CHESS-mission/PULSE_ENG_PCB/PULSE_3D_Models/C3216X8R1E475M160AE.stp

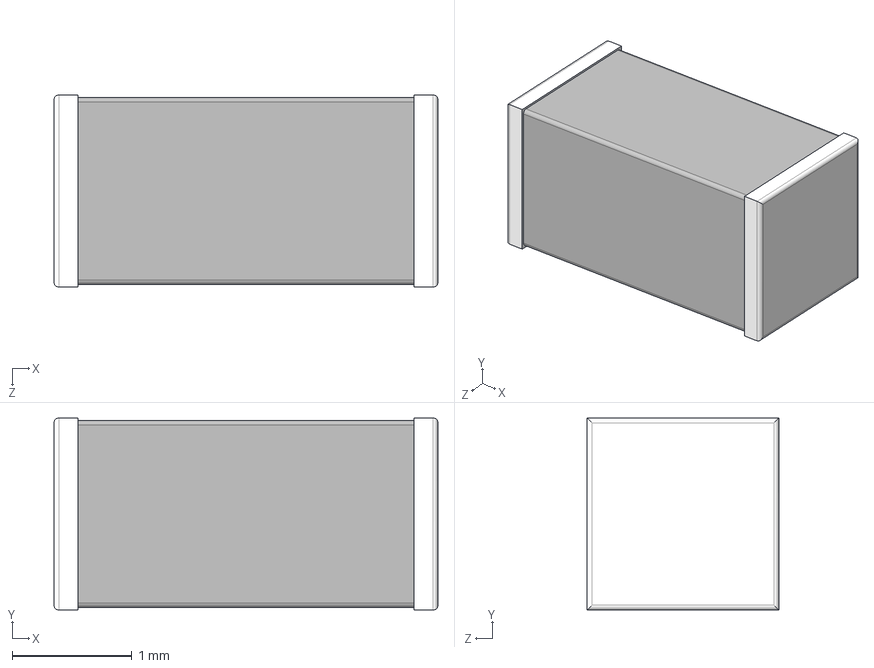
[picture p1: CAD file, 2026-02-26]
PULSE_3D_Models/C3216X8R1E475M160AE.stp
3.20 x 1.60 x 1.60 mm
