CHESS-mission/PULSE_ENG_PCB/PULSE_3D_Models/LM139DR.stp

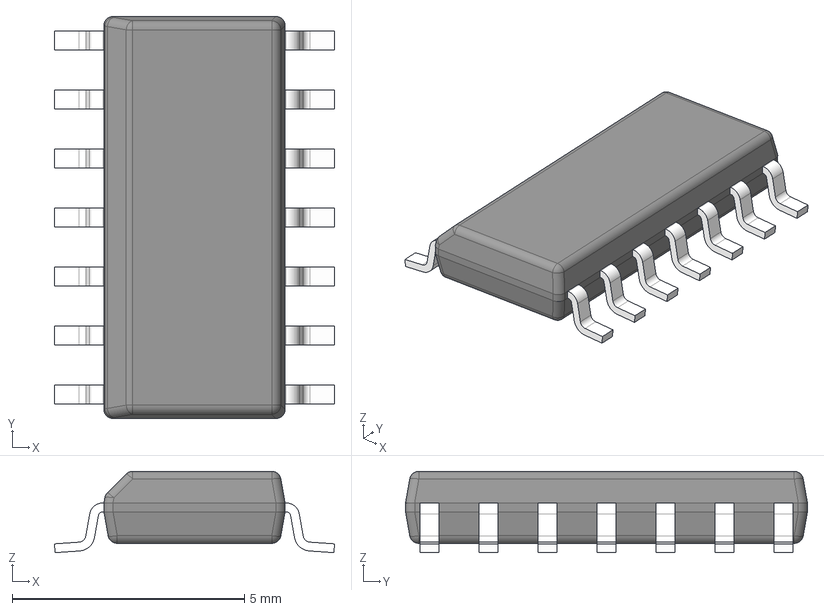
[picture p2: CAD file, 2026-02-26]
PULSE_3D_Models/LM139DR.stp
6.03 x 8.65 x 1.75 mm
BODY-SO
LEAD-SO x 14
PIN1-ID
