CHESS-mission/PULSE_ENG_PCB/PULSE_3D_Models/TPS7B8750QDDARQ1.stp

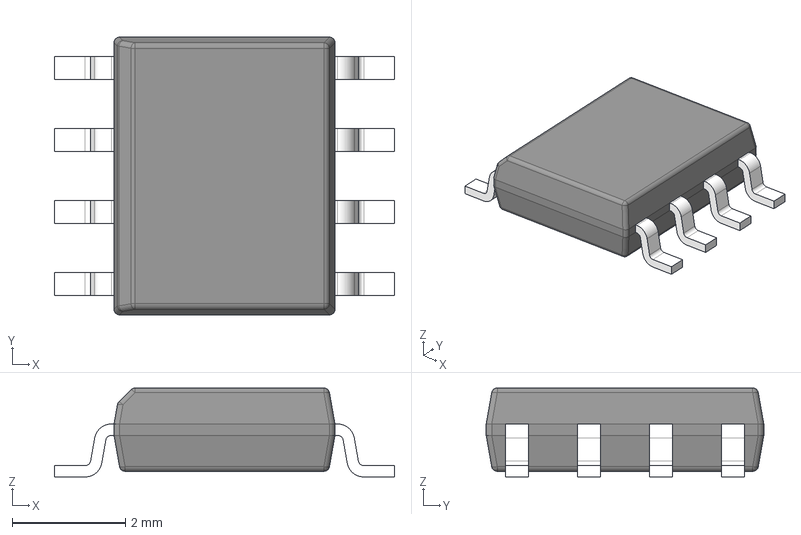
[picture p3: CAD file, 2026-02-26]
PULSE_3D_Models/TPS7B8750QDDARQ1.stp
6.00 x 4.90 x 1.57 mm
BODY-SO
LEAD-SO x 8
THERMALPAD-SO
