CHESS-mission/PULSE_ENG_PCB/PULSE_3D_Models/LT6108AIMS8-1#PBF.stp

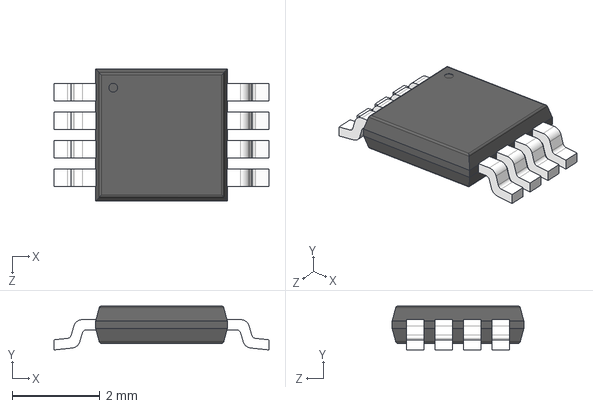
[picture p4: CAD file, 2026-02-26]
PULSE_3D_Models/LT6108AIMS8-1#PBF.stp
4.90 x 1.00 x 3.00 mm
