CHESS-mission/PULSE_ENG_PCB/PULSE_3D_Models/VJ1206Y104KXXAC.stp

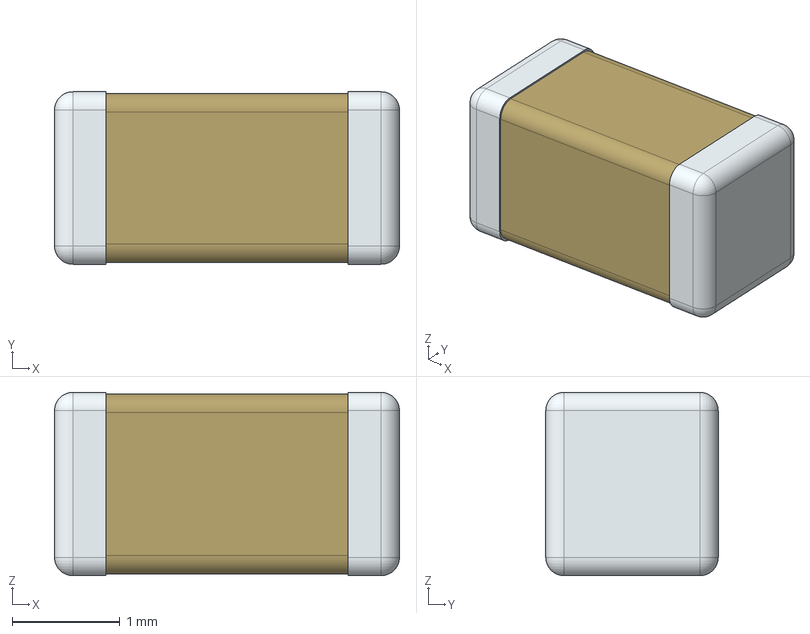
[picture p5: CAD file, 2026-02-26]
PULSE_3D_Models/VJ1206Y104KXXAC.stp
3.20 x 1.60 x 1.70 mm
