CHESS-mission/PULSE_ENG_PCB/PULSE_3D_Models/C2012X8R1E105M125AE.stp

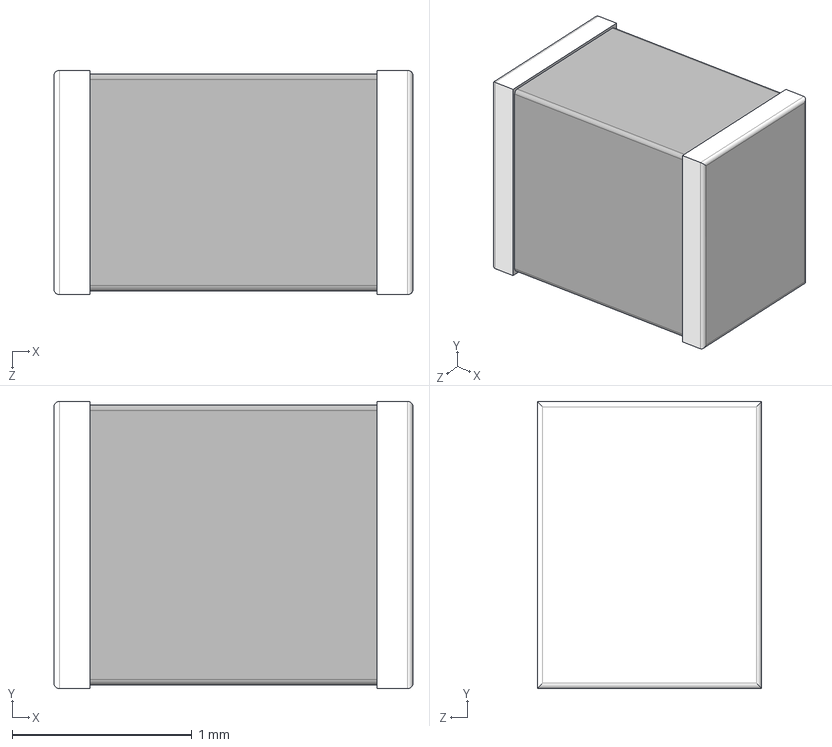
[picture p6: CAD file, 2026-02-26]
PULSE_3D_Models/C2012X8R1E105M125AE.stp
2.00 x 1.60 x 1.25 mm
