CHESS-mission/PULSE_ENG_PCB/PULSE_3D_Models/ATSAMD21G17A-AU.stp

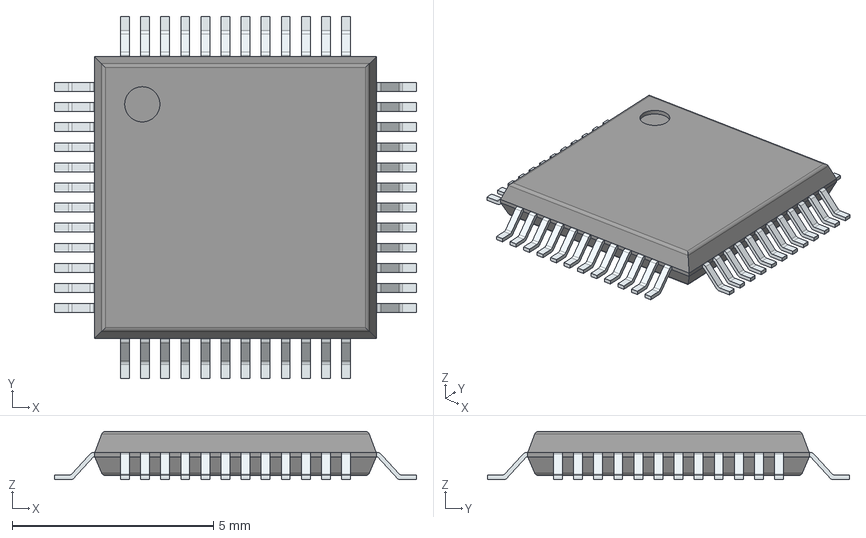
[picture p7: CAD file, 2026-02-26]
PULSE_3D_Models/ATSAMD21G17A-AU.stp
9.00 x 9.00 x 1.20 mm
PinsArrayLR
PinsArrayTB
