CHESS-mission/PULSE_ENG_PCB/PULSE_3D_Models/TW-08-07-G-D-375-188.stp

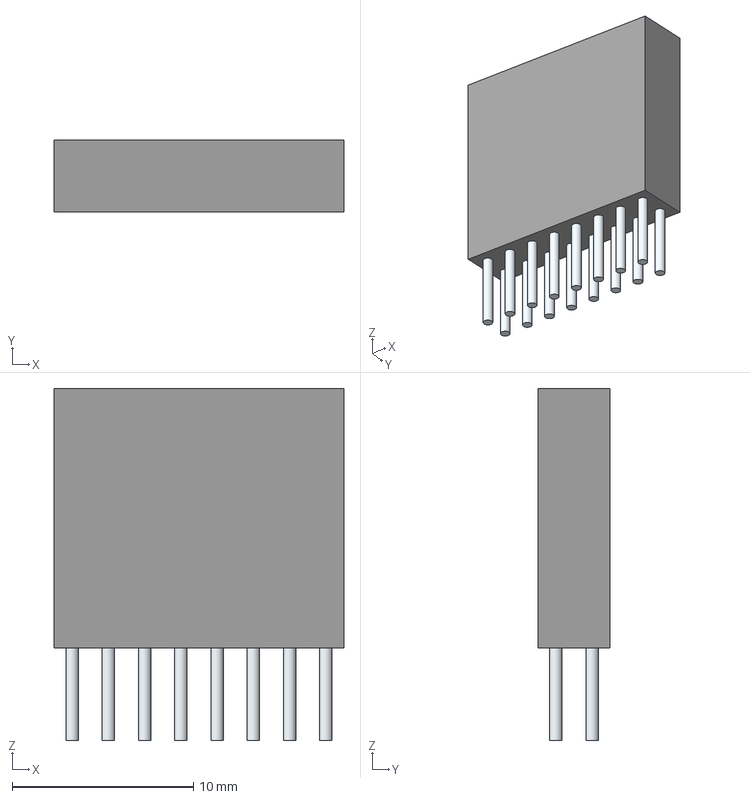
[picture p8: CAD file, 2025-12-04]
PULSE_3D_Models/TW-08-07-G-D-375-188.stp
16.0 x 4.00 x 19.4 mm
Leads
