CHESS-mission/PULSE_ENG_PCB/PULSE_3D_Models/ADM3071EARZ.stp

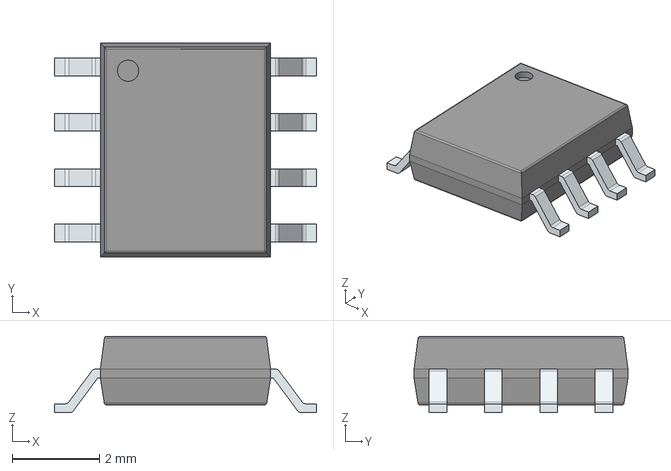
[picture p9: CAD file, 2025-12-02]
PULSE_3D_Models/ADM3071EARZ.stp
6.00 x 4.90 x 1.75 mm
PinsArrayLR
