CHESS-mission/PULSE_ENG_PCB/PULSE_3D_Models/TC2030-IDC-NL.stp

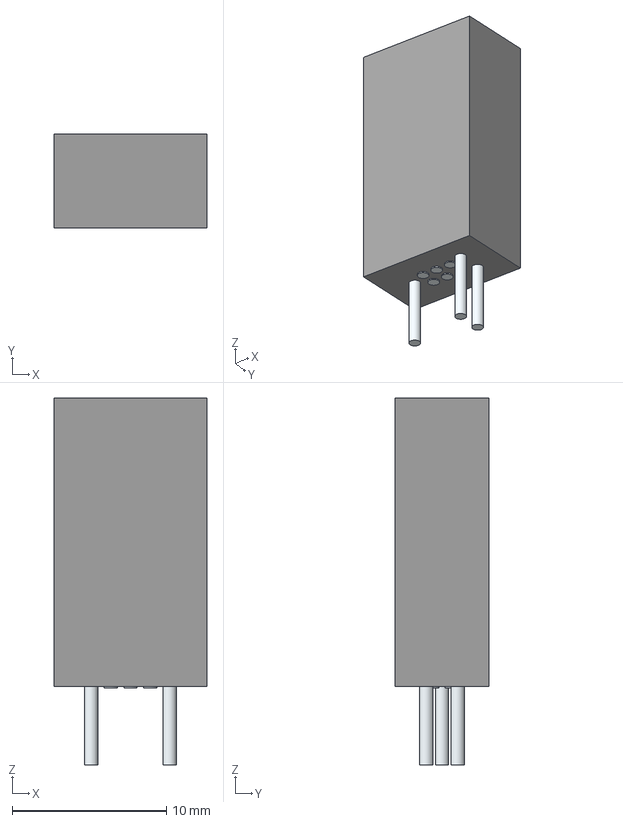
[picture p10: CAD file, 2025-12-02]
PULSE_3D_Models/TC2030-IDC-NL.stp
9.91 x 6.10 x 23.8 mm
Pins
Leads x 3
