CHESS-mission/PULSE_ENG_PCB/PULSE_3D_Models/C0603X474J4RACAUTO.stp

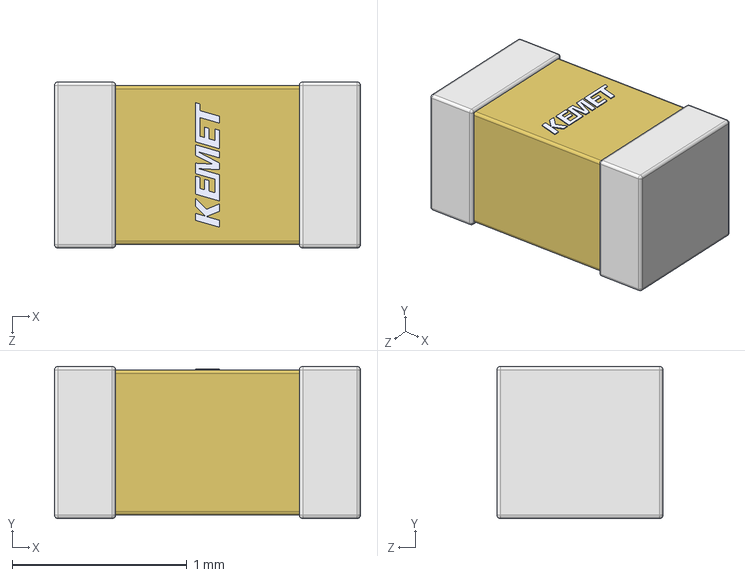
[picture p11: CAD file, 2025-12-01]
PULSE_3D_Models/C0603X474J4RACAUTO.stp
1.75 x 0.87 x 0.95 mm
