CHESS-mission/PULSE_ENG_PCB/PULSE_3D_Models/C0805C475K4RACAUTO.stp

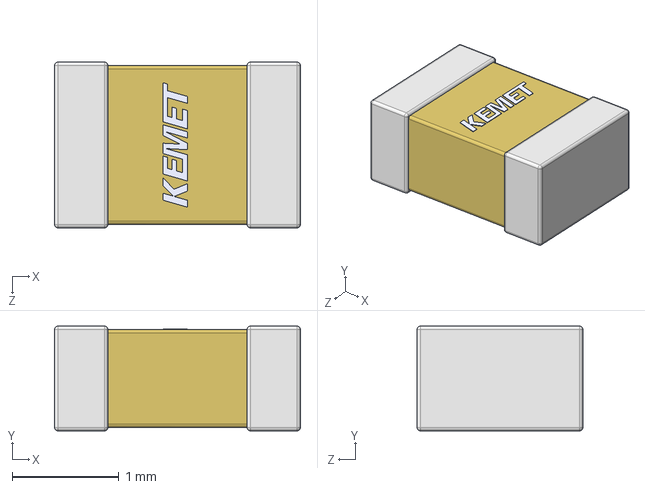
[picture p12: CAD file, 2025-12-01]
PULSE_3D_Models/C0805C475K4RACAUTO.stp
2.30 x 0.98 x 1.55 mm
