CHESS-mission/PULSE_ENG_PCB/PULSE_3D_Models/DMN4035LQ-13.stp

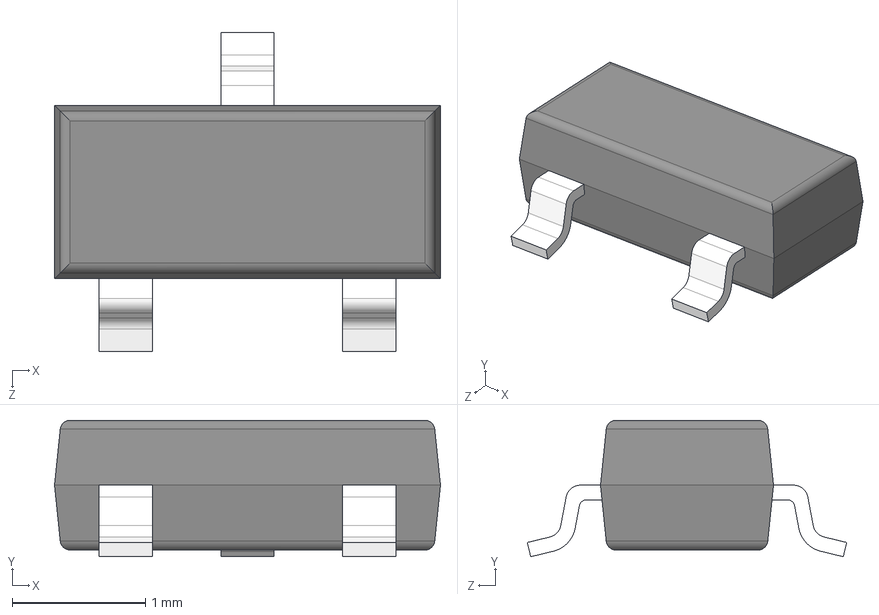
[picture p13: CAD file, 2025-12-01]
PULSE_3D_Models/DMN4035LQ-13.stp
2.90 x 1.02 x 2.40 mm
