CHESS-mission/PULSE_ENG_PCB/PULSE_3D_Models/GRT32EC81C476KE13L.stp

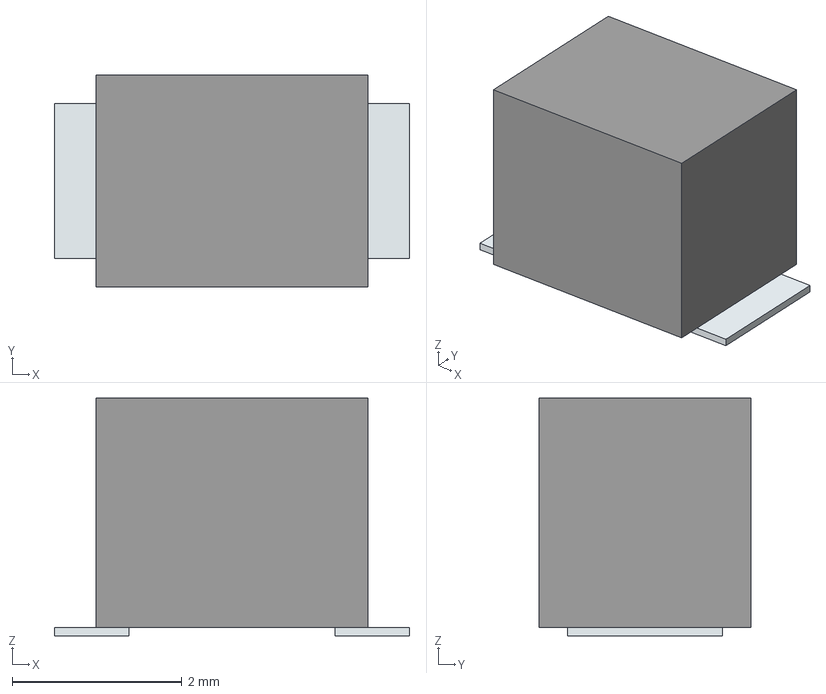
[picture p14: CAD file, 2025-12-01]
PULSE_3D_Models/GRT32EC81C476KE13L.stp
4.18 x 2.50 x 2.80 mm
Pins
