CHESS-mission/PULSE_ENG_PCB/PULSE_3D_Models/PMR18EZPFV2L00.stp

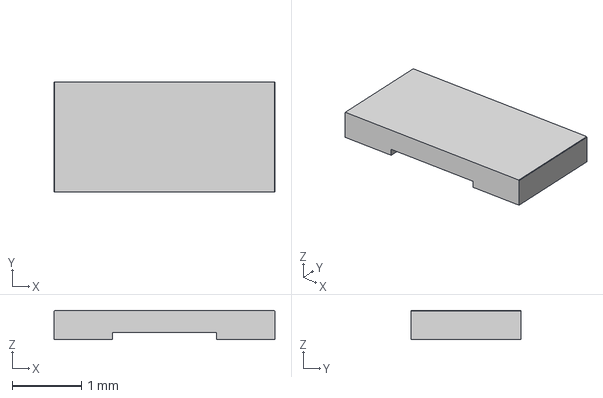
[picture p15: CAD file, 2025-12-01]
PULSE_3D_Models/PMR18EZPFV2L00.stp
3.20 x 1.60 x 0.42 mm
