CHESS-mission/PULSE_ENG_PCB/PULSE_3D_Models/TNPW0603100KBEEA.stp

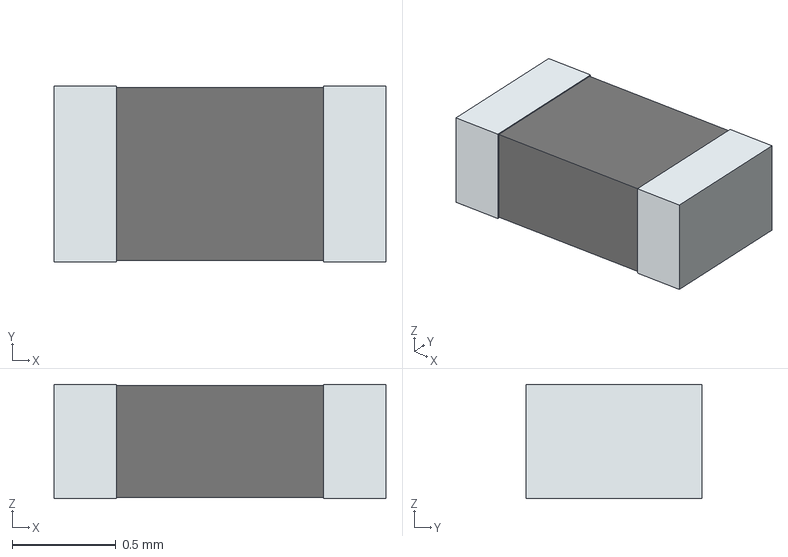
[picture p16: CAD file, 2025-12-01]
PULSE_3D_Models/TNPW0603100KBEEA.stp
1.60 x 0.85 x 0.55 mm
term1
term2
