CHESS-mission/PULSE_ENG_PCB/PULSE_3D_Models/CC0805KKX7R7BB106.stp

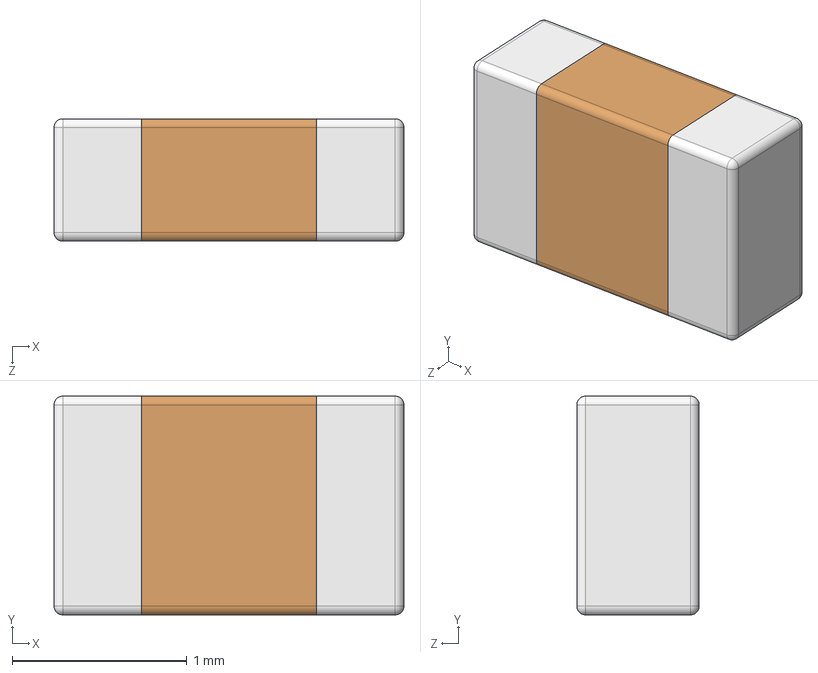
[picture p17: CAD file, 2025-12-01]
PULSE_3D_Models/CC0805KKX7R7BB106.stp
2.00 x 1.25 x 0.7 mm
