CHESS-mission/PULSE_ENG_PCB/PULSE_3D_Models/ESQ-126-24-G-D.stp

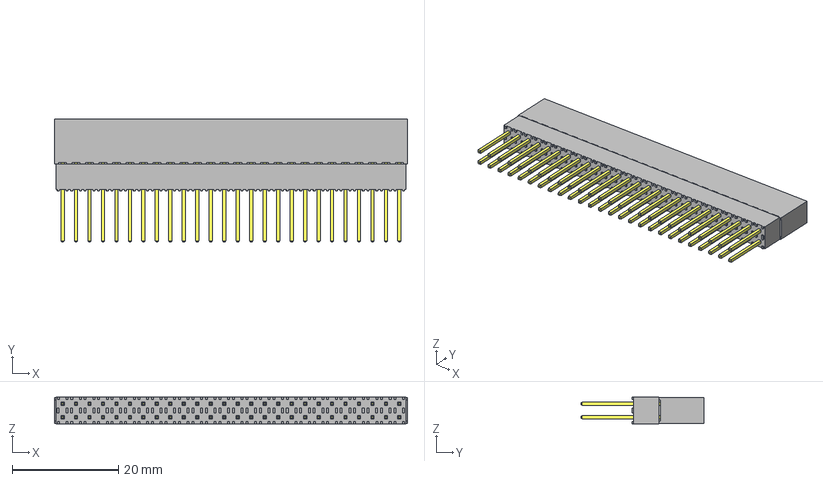
[picture p18: CAD file, 2025-11-27]
PULSE_3D_Models/ESQ-126-24-G-D.stp
66.5 x 23.2 x 5.08 mm
ESQ-126-24-G-D_socket
ESQ-126-24-G-D_pins
ESQ-126-24-G-D2_pins
ESQ-126-24-G-D-LL_bpins
