CHESS-mission/PULSE_ENG_PCB/PULSE_3D_Models/EPC2152ENGRT--3DModel-STEP-269445.STEP

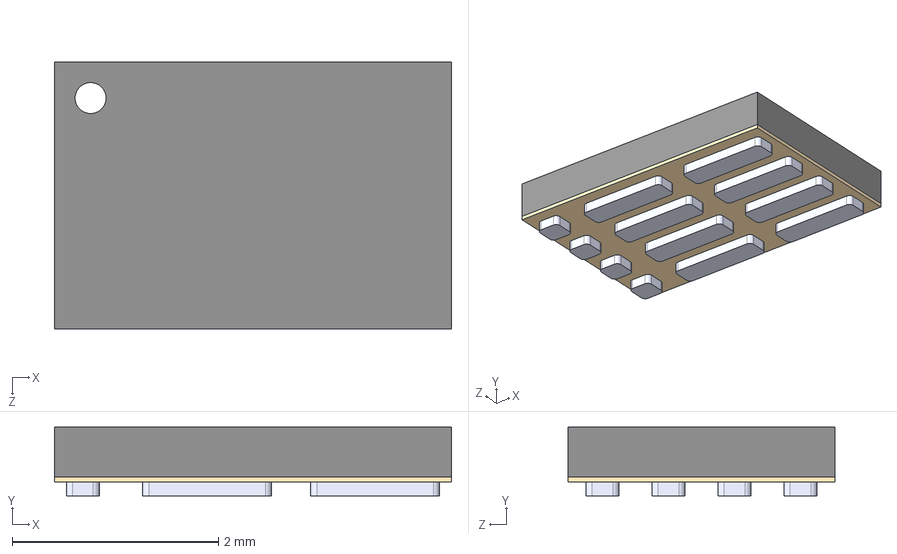
[picture p19: CAD file, 2025-11-26]
PULSE_3D_Models/EPC2152ENGRT--3DModel-STEP-269445.STEP
3.85 x 0.665 x 2.59 mm
