CHESS-mission/PULSE_ENG_PCB/PULSE_3D_Models/AMDLA4020S-220MT.stp

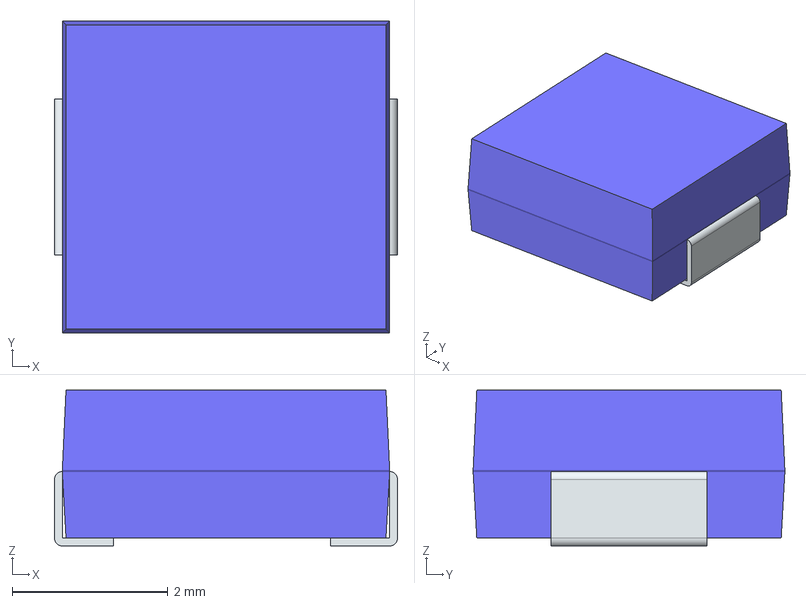
[picture p20: CAD file, 2025-11-24]
PULSE_3D_Models/AMDLA4020S-220MT.stp
4.40 x 4.00 x 2.00 mm
FilletPin1
FilletPin2
