CHESS-mission/PULSE_ENG_PCB/PULSE_3D_Models/RT0603BRB0710KL.stp

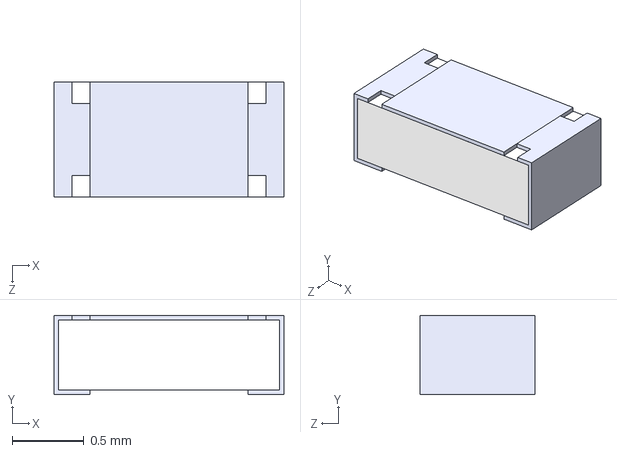
[picture p21: CAD file, 2025-11-24]
PULSE_3D_Models/RT0603BRB0710KL.stp
1.60 x 0.55 x 0.8 mm
