CHESS-mission/PULSE_ENG_PCB/PULSE_3D_Models/INA226AIDGSR.stp

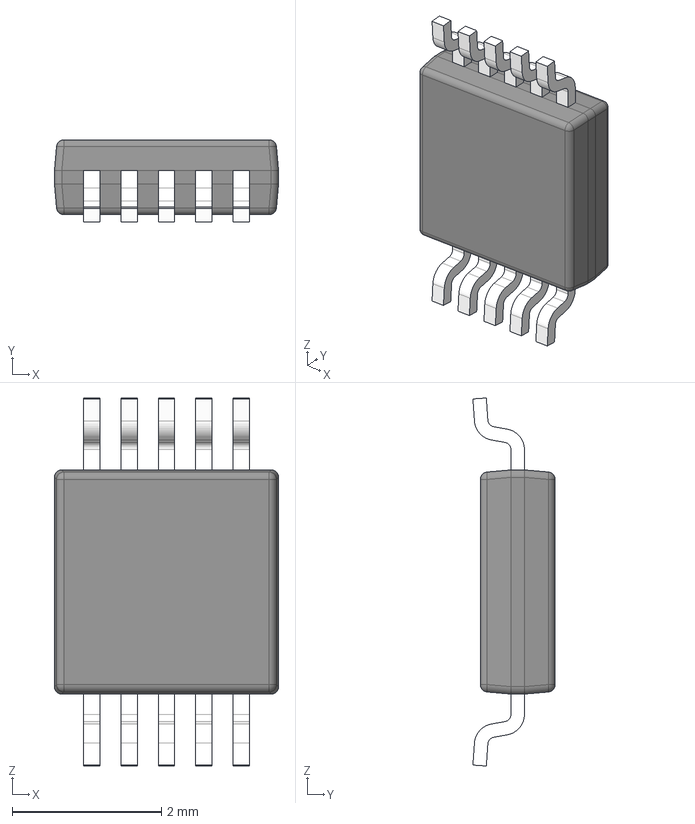
[picture p22: CAD file, 2025-11-24]
PULSE_3D_Models/INA226AIDGSR.stp
3.00 x 1.10 x 4.93 mm
BODY-SO
LEAD-SO x 10
PIN1-ID
