CHESS-mission/PULSE_ENG_PCB/PULSE_3D_Models/AS0805KKX7R8BB105.stp

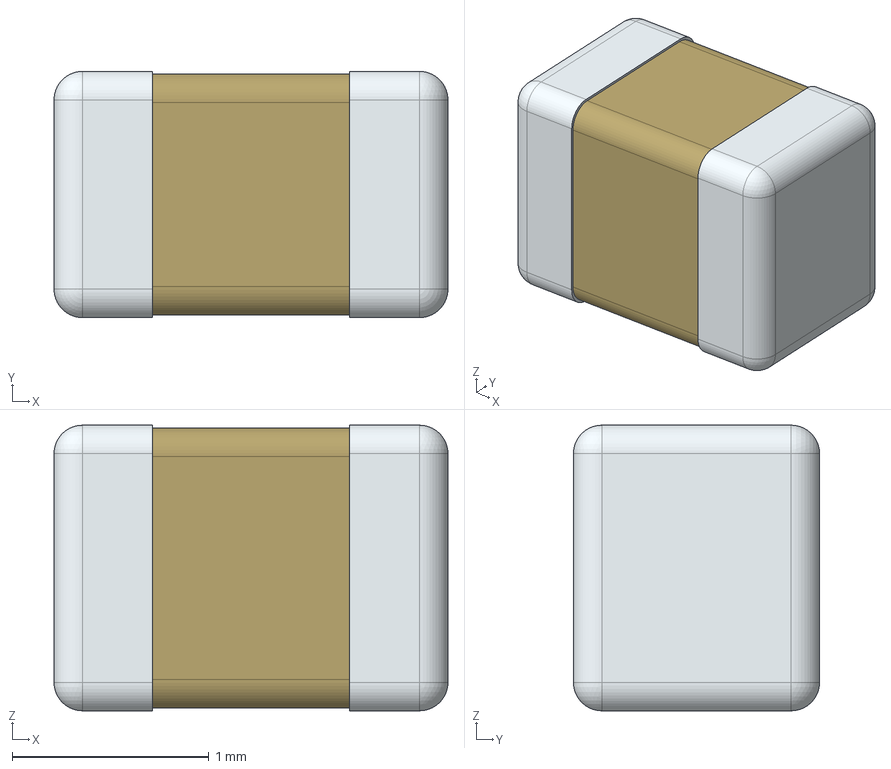
[picture p23: CAD file, 2025-11-24]
PULSE_3D_Models/AS0805KKX7R8BB105.stp
2.00 x 1.25 x 1.45 mm
