CHESS-mission/PULSE_ENG_PCB/PULSE_3D_Models/PA0805FRE470R002L.stp

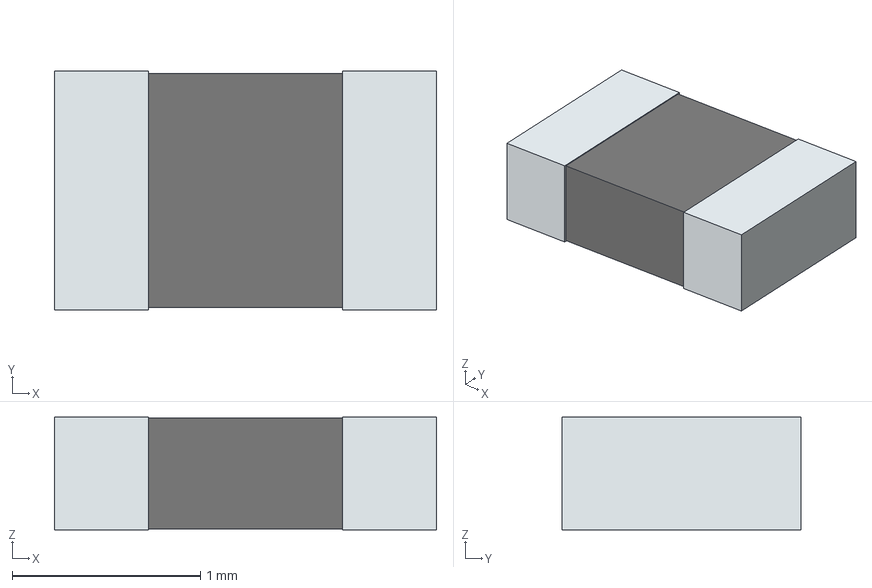
[picture p24: CAD file, 2025-11-24]
PULSE_3D_Models/PA0805FRE470R002L.stp
2.03 x 1.27 x 0.6 mm
term1
term2
