CHESS-mission/PULSE_ENG_PCB/PULSE_3D_Models/C1812C106K3RACTM.stp

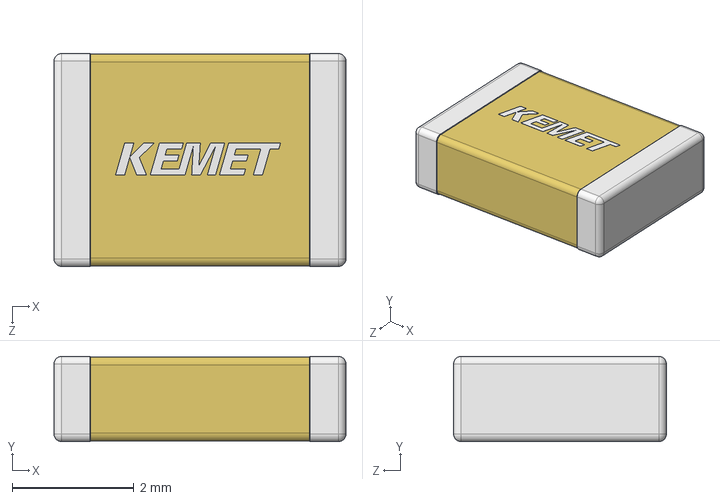
[picture p25: CAD file, 2025-11-24]
PULSE_3D_Models/C1812C106K3RACTM.stp
4.80 x 1.40 x 3.50 mm
Base_139
Termination_139 x 2
