CHESS-mission/PULSE_ENG_PCB/PULSE_3D_Models/L6982C50DR.stp

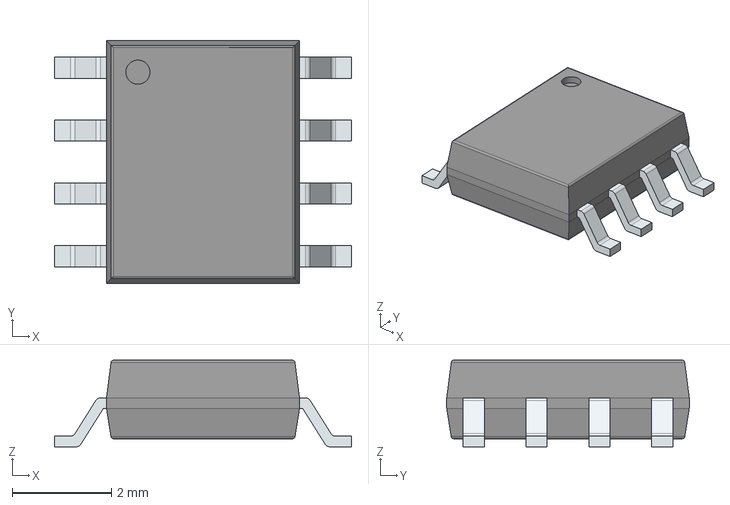
[picture p26: CAD file, 2025-11-24]
PULSE_3D_Models/L6982C50DR.stp
6.00 x 4.90 x 1.75 mm
PinsArrayLR
