CHESS-mission/PULSE_ENG_PCB/PULSE_3D_Models/MBASL32MSB5476KPNA01.stp

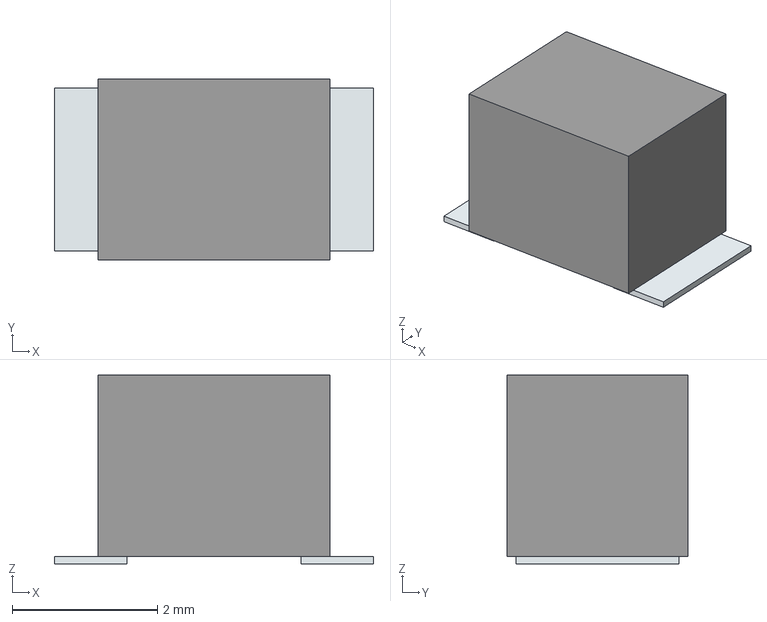
[picture p27: CAD file, 2025-11-24]
PULSE_3D_Models/MBASL32MSB5476KPNA01.stp
4.40 x 2.50 x 2.60 mm
Pins
