CHESS-mission/PULSE_ENG_PCB/(list of files, cad)

Other CAD files:
PULSE_3D_Models/C0603C104K4NACAUTO.stp
PULSE_3D_Models/L6982C33DR.stp
PULSE_3D_Models/MAX890LESA+.stp
PULSE_3D_Models/78404084470.stp
PULSE_3D_Models/LM74700QDBVRQ1.stp
PULSE_3D_Models/MAX17523ATE+.stp
PULSE_3D_Models/TPS25940ARVCR.stp
