CHESS-mission/PULSE_ENG_PCB/PULSE_ENG.kicad_pcb

## KiCad design PULSE_ENG.kicad_pcb (2026-02-26)

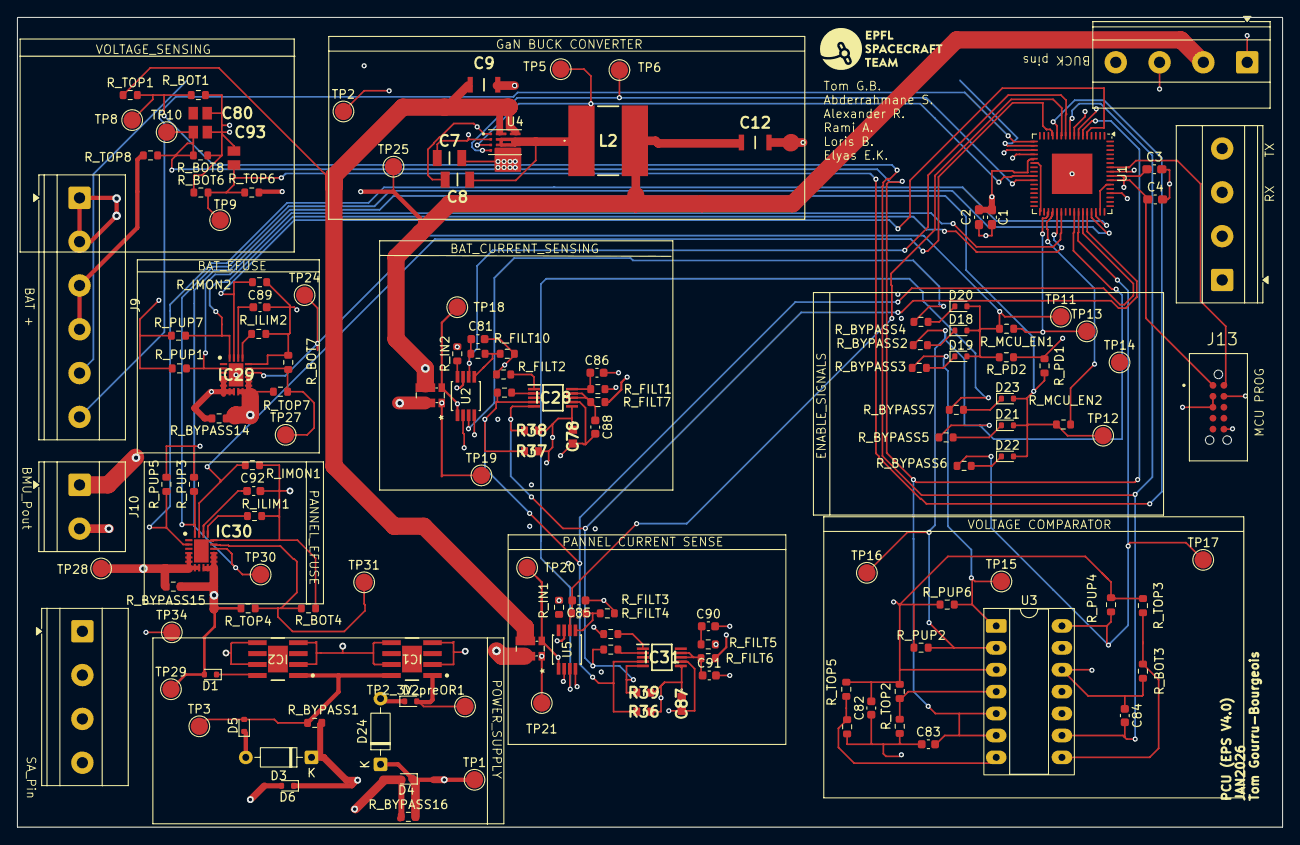
[picture p28: board PULSE_ENG.kicad_pcb from above]

Board: 4 copper layers, 146.7 x 93.9 mm, 144 parts (0 on the bottom side), 84 nets.

Parts:
C1, C4: 100nF; C_0603_1608Metric_Pad1.08x0.95mm_HandSolder
C2, C3: 10uF; C_0603_1608Metric_Pad1.08x0.95mm_HandSolder
C7, C8: CAPC3216X170N
C9: 4.7uF; CAPC3216X180N
C12: C3216X8L1E106K160AE; CAPC3216X180N
C78, C87: 0.1μF; C0603
C79, C80, C93: 10nF; CAPC2012X145N
C81, C82, C83, C84, C85, C86, C88, C89, C90, C91, C92: 100nF; C_0603_1608Metric
D1, D2, D4, D5, D6, D18, D19, D20, D21, D22, D23: 1N4148WT; D_SOD-523
D3, D24: 1N5711; D_DO-35_SOD27_P7.62mm_Horizontal
IC1: TPS7B8733QDDARQ1; DDA0008J-IPC_B
IC2: TPS7B8750QDDARQ1; DDA0008J-IPC_B
IC28, IC31: INA226AIDGSR; SOP50P490X110-10N
IC29, IC30: TPS25940ARVCR; QFN50P300X400X80-21N
J8, J11, J12: Screw_Terminal_01x04; TerminalBlock_Phoenix_MKDS-1,5-4-5.08_1x04_P5.08mm_Horizont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
J9: Screw_Terminal_01x06; TerminalBlock_Phoenix_MKDS-1,5-6-5.08_1x06_P5.08mm_Horizont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
J10: Screw_Terminal_01x01; TerminalBlock_Phoenix_MKDS-1,5-2-5.08_1x02_P5.08mm_Horizont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
J13: TC2050-IDC-NL; TAG-CONNECT_TC2050-IDC-NL
L2: 78404084470
R36, R37, R38, R39: 10KΩ; RESC1608X55N
R_ADD_CONFIG1, R_ADD_CONFIG2, R_ADD_CONFIG3, R_ADD_CONFIG4: 0; R_0603_1608Metric
R_BAT_SHUNT1: 20mOhm; R_Shunt_Vishay_WSKW0612
R_BOT1, R_BOT2, R_BOT3, R_BOT5, R_BOT6, R_BOT8: 180k; R_0603_1608Metric
R_BOT4, R_BOT7: 100k; R_0603_1608Metric
R_BYPASS1, R_BYPASS2, R_BYPASS3, R_BYPASS4, R_BYPASS5, R_BYPASS6, R_BYPASS7, R_BYPASS14, R_BYPASS15, R_BYPASS16: 0; R_0603_1608Metric
R_FILT1, R_FILT5, R_FILT6, R_FILT7: 10; R_0603_1608Metric
R_FILT2, R_FILT4: 2.61k; R_0603_1608Metric
R_FILT3, R_FILT10: 402; R_0603_1608Metric
R_ILIM1: 24k; R_0603_1608Metric
R_ILIM2: 16.9k; R_0603_1608Metric
R_IMON1, R_IMON2: 4k; R_0603_1608Metric
R_IN1, R_IN2: 100; R_0603_1608Metric
R_MCU_EN1, R_MCU_EN2: 1k; R_0603_1608Metric
R_PANNEL_SHUNT1: 20mOhm; R_Shunt_Vishay_WSKW0612
R_PD1, R_PD2: 100k; R_0603_1608Metric
R_PUP1, R_PUP2, R_PUP3, R_PUP4, R_PUP5, R_PUP6, R_PUP7: 10k; R_0603_1608Metric
R_TOP1, R_TOP6, R_TOP8: 680k; R_0603_1608Metric
R_TOP2: 147k; R_0603_1608Metric
R_TOP3: 68k; R_0603_1608Metric
R_TOP4, R_TOP7: 681; R_0603_1608Metric
R_TOP5: 247k; R_0603_1608Metric
TP1: 3V3_rail; TestPoint_Pad_D2.0mm
TP2: 12Vin_buck; TestPoint_Pad_D2.0mm
TP2_3V_preOR1: TestPoint_Pad_D2.0mm
TP3: 5V_preOR; TestPoint_Pad_D2.0mm
TP5: PWM_H; TestPoint_Pad_D2.0mm
TP6: PWM_L; TestPoint_Pad_D2.0mm
TP8: VPANNEL_SENSE; TestPoint_Pad_D2.0mm
TP9: VCHG_RAIL_SENSE; TestPoint_Pad_D2.0mm
TP10: VBAT_SENSE; TestPoint_Pad_D2.0mm
TP11: BAT_EFUSE_EN; TestPoint_Pad_D2.0mm
TP12: PANNEL_EFUSE_EN; TestPoint_Pad_D2.0mm
TP13: MCU_BAT_EFUSE_EN; TestPoint_Pad_D2.0mm
TP14: MCU_PANNEL_EFUSE_EN; TestPoint_Pad_D2.0mm
TP15: BAT_UVP; TestPoint_Pad_D2.0mm
TP16: BAT_OVP; TestPoint_Pad_D2.0mm
TP17: PANNEL_OVP; TestPoint_Pad_D2.0mm
TP18: BAT_SHUNT_OUT; TestPoint_Pad_D2.0mm
TP19: BAT_SHUNT_IN; TestPoint_Pad_D2.0mm
TP20: PANNEL_SHUNT_OUT; TestPoint_Pad_D2.0mm
TP21: PANNEL_SHUNT_IN; TestPoint_Pad_D2.0mm
TP24: eFUSE_EN; TestPoint_Pad_D2.0mm
TP25: Buck_out; TestPoint_Pad_D2.0mm
TP27: eFUSE_OVP; TestPoint_Pad_D2.0mm
TP28: P_Vout_Protected; TestPoint_Pad_D2.0mm
TP29: PVin; TestPoint_Pad_D2.0mm
TP30: eFuse_EN; TestPoint_Pad_D2.0mm
TP31: eFuse_OVP; TestPoint_Pad_D2.0mm
TP34: GND; TestPoint_Pad_D2.0mm
U1: ATSAMD21J17D-M; QFN-64-1EP_9x9mm_P0.5mm_EP4.7x4.7mm
U2, U5: LT6108IMS8-1-TRPBF; MSOP-8_MS_LIT
U3: LM139ADRG4; CERDIP-14_W7.62mm_SideBrazed_LongPads_Socket
U4: EPC2152; VREG_EPC2152ENGRT

Connections:
12V_1: C7.1, J11.1, TP2.1, U4.2 (Vdd12)
/3.3V: C78.1, IC28.6 (VS), R37.2, R38.2, R_PUP1.2, R_PUP7.2
/5V: D3.1 (K), D6.1 (K), R_BYPASS1.2
/BAT_EFUSE_EN: D18.2 (A), D19.2 (A), D20.2 (A), IC29.14 (EN), R_MCU_EN1.1, R_PD2.2, TP11.1, TP24.1
/BAT_EFUSE_FLT: IC29.20 (~FLT), R_PUP7.1, U1.37 (PA18)
/BAT_EFUSE_IMON: IC29.19 (IMON), R_IMON2.2, U1.5 (PB04)
/BAT_EFUSE_PGOOD: IC29.2 (PGOOD), R_PUP1.1, U1.38 (PA19)
/BAT_OVP_FLAG: R_BYPASS2.1, R_BYPASS5.1, R_PUP2.2, TP16.1, U1.41 (PA20), U3.2 (2OUT)
/BAT_SHUNT_IN: R_BAT_SHUNT1.3, R_FILT1.1, R_IN2.2, TP19.1, U2.7 (V+)
/BAT_SHUNT_OUT: R_BAT_SHUNT1.2, R_FILT7.1, TP18.1, U2.1 (SENSELO)
/BAT_UVP_FLAG: R_BYPASS3.1, R_PUP6.2, TP15.1, U3.1 (1OUT)
/Battery_protection_and_sensing/P_Vout_Protected: IC29.4 (OUT_1), IC29.5 (OUT_2), IC29.6 (OUT_3), IC29.7 (OUT_4), IC29.8 (OUT_5), J10.1, R_BYPASS14.2
/EPS_Power_Supply/3V3_LDO: D2.2 (A), IC1.1 (OUT), TP2_3V_preOR1.1
/EPS_Power_Supply/5V_LDO: D5.2 (A), IC1.8 (IN), IC2.1 (OUT), R_BYPASS1.1, TP3.1
/GAN_PWM_H: TP5.1, U1.25 (PB12), U4.3 (HSin)
/GAN_PWM_L: TP6.1, U1.26 (PB13), U4.4 (LSin)
/HEATER_SWITCH: J9.6, U1.17 (PA08)
/I_BAT_ANA: C81.2, R_FILT10.2, U1.10 (PB07), U2.6 (OUTA)
/I_PANNEL_ANA: C85.2, R_FILT3.2, U1.11 (PB08), U5.6 (OUTA)
/MCU_BAT_EFUSE_EN: R_MCU_EN1.2, TP13.1, U1.35 (PA16)
/MCU_PANNEL_EFUSE_EN: R_MCU_EN2.2, TP14.1, U1.36 (PA17)
/PANNEL_EFUSE_EN: D21.2 (A), D22.2 (A), D23.2 (A), IC30.14 (EN), R_MCU_EN2.1, R_PD1.2, TP12.1, TP30.1
/PANNEL_OVP_FLAG: R_BYPASS6.1, R_PUP4.1, TP17.1, U1.42 (PA21), U3.14 (OUT3)
/PANNEL_SHUNT_IN: R_FILT6.1, R_IN1.2, R_PANNEL_SHUNT1.3, TP21.1, U5.7 (V+)
/PANNEL_SHUNT_OUT: R_FILT5.1, R_PANNEL_SHUNT1.2, TP20.1, U5.1 (SENSELO)
/PAN_EFUSE_FLT: IC30.20 (~FLT), R_PUP3.1, U1.45 (PA24)
/PAN_EFUSE_IMON: IC30.19 (IMON), R_IMON1.2, U1.13 (PA04)
/PAN_EFUSE_PGOOD: IC30.2 (PGOOD), R_PUP5.1, U1.46 (PA25)
/PCU_Control/BAT_OVC: R_BYPASS4.1, U2.3 (OUTC)
/PCU_Control/PANNEL_OVC: R_BYPASS7.1, U5.3 (OUTC)
/POWER_SWITCH: J9.5, U1.18 (PA09)
/Pannel_protection_and_sensing/PV_protected: IC30.4 (OUT_1), IC30.5 (OUT_2), IC30.6 (OUT_3), IC30.7 (OUT_4), IC30.8 (OUT_5), R_BYPASS15.2, R_PANNEL_SHUNT1.4, TP28.1
/RESET: J13.6, U1.52 (~RESET)
/TEST_3V_PDU: D4.2 (A), J8.2, R_BYPASS16.1
/TEST_5V_PDU: D6.2 (A), J8.3
/TEST_Pin_SA: D1.2 (A), IC30.9 (IN_1), IC30.10 (IN_2), IC30.11 (IN_3), IC30.12 (IN_4), IC30.13 (IN_5), J8.4, R_BYPASS15.1, R_TOP4.1, TP29.1
/UART1_RX: J12.3, U1.20 (PA11)
/UART1_TX: J12.4, U1.19 (PA10)
/VBAT_SENSE: C83.2, C93.1, R_BOT8.2, R_TOP8.2, TP10.1, U1.6 (PB05), U3.5 (2IN+), U3.6 (1IN-)
/VCHG_RAIL_SENSE: C79.1, R_BOT6.2, R_TOP6.2, TP9.1, U1.12 (PB09)
/VPANNEL_SENSE: C80.1, C84.2, R_BOT1.2, R_TOP1.2, TP8.1, U1.9 (PB06), U3.9 (3IN+)
/V_pannel_protected: C9.2, R_PANNEL_SHUNT1.1, R_TOP1.1, U4.5 (Vin), U4.9 (Vin)
/Vbat: J9.3, J9.4, R_BAT_SHUNT1.4, R_TOP8.1
/Vout_BUCK: C12.2, IC29.9 (IN_1), IC29.10 (IN_2), IC29.11 (IN_3), IC29.12 (IN_4), IC29.13 (IN_5), J11.2, L2.2, R_BAT_SHUNT1.1, R_BYPASS14.1, R_TOP6.1, R_TOP7.1, TP25.1
GND: C1.2, C2.2, C3.2, C4.2, C7.2, C78.2, C79.2, C80.2, C81.1, C82.2, C83.1, C84.1, C85.1, C86.2, C87.2, C88.2, C89.1, C90.2, C91.2, C92.1, C93.2, IC1.2 (NC_1), IC1.4 (NC_2), IC1.5 (GND), IC1.7 (NC_3), IC2.2 (NC_1), IC2.4 (NC_2), IC2.5 (GND), IC2.7 (NC_3), IC28.7 (GND), IC29.16 (GND), IC29.21 (EPAD), IC30.16 (GND), IC30.21 (EPAD), IC31.7 (GND), J8.1, J9.1, J9.2, J11.4, J12.1, J12.2, J13.2, J13.3, R_ADD_CONFIG2.1, R_ADD_CONFIG4.1, R_BOT1.1, R_BOT2.1, R_BOT3.1, R_BOT4.2, R_BOT5.1, R_BOT6.1, R_BOT7.2, R_BOT8.1, R_FILT2.1, R_FILT4.1, R_ILIM1.2, R_ILIM2.2, R_IMON1.1, R_IMON2.1, R_PD1.1, R_PD2.1, TP34.1, U1.7 (GNDANA), U1.65 (EP), U2.4 (V-), U3.12 (GND), U4.8 (Vss), U5.4 (V-)
unnamed: C8.1, L2.1, U4.6 (SW), U4.7 (SW), U4.10 (SW), U4.11 (SW)
unnamed: C9.1, C12.1, U4.12 (Vss)
unnamed: D1.1 (K), IC2.8 (IN)
unnamed: D2.1 (K), D24.2 (A)
unnamed: D3.2 (A), D5.1 (K)
unnamed: D18.1 (K), R_BYPASS2.2
unnamed: D19.1 (K), R_BYPASS3.2
unnamed: D20.1 (K), R_BYPASS4.2
unnamed: D21.1 (K), R_BYPASS5.2
unnamed: D22.1 (K), R_BYPASS6.2
unnamed: D23.1 (K), R_BYPASS7.2
unnamed: IC28.2 (A0), R_ADD_CONFIG1.2
unnamed: IC28.1 (A1), R_ADD_CONFIG4.2
unnamed: C86.1, IC28.10 (IN+), R_FILT7.2
unnamed: C88.1, IC28.8 (VBUS), IC28.9 (IN-), R_FILT1.2
unnamed: C89.2, IC29.18 (DVDT)
unnamed: IC29.17 (ILIM), R_ILIM2.1
unnamed: IC29.15 (OVP), R_BOT7.1, R_TOP7.2, TP27.1
unnamed: C92.2, IC30.18 (DVDT)
unnamed: IC30.17 (ILIM), R_ILIM1.1
unnamed: IC30.15 (OVP), R_BOT4.1, R_TOP4.2, TP31.1
unnamed: IC31.2 (A0), R_ADD_CONFIG3.2
unnamed: IC31.1 (A1), R_ADD_CONFIG2.2
unnamed: C90.1, IC31.10 (IN+), R_FILT5.2
unnamed: C91.1, IC31.8 (VBUS), IC31.9 (IN-), R_FILT6.2
unnamed: C8.2, J11.3, U4.1 (Vdd12F)
unnamed: U1.22 (GND), U1.33 (GND), U1.47 (GND), U1.54 (GND)
unnamed: R_FILT2.2, R_FILT10.1, U2.5 (INC)
unnamed: R_IN2.1, U2.8 (SENSEHI)
unnamed: R_BOT5.2, R_TOP5.1, U3.7 (1IN+)
unnamed: R_BOT2.2, R_TOP2.1, U3.4 (2IN-)
unnamed: R_BOT3.2, R_TOP3.1, U3.8 (3IN-)
unnamed: R_FILT3.1, R_FILT4.2, U5.5 (INC)
unnamed: R_IN1.1, U5.8 (SENSEHI)
SCL2: IC28.5 (SCL), IC31.5 (SCL), R38.1, R39.1, R_ADD_CONFIG3.1, U1.44 (PA23)
SDA2: IC28.4 (SDA), IC31.4 (SDA), R36.1, R37.1, R_ADD_CONFIG1.1, U1.43 (PA22)
SWCLK: J13.9, U1.57 (PA30)
SWDIO: J13.10, U1.58 (PA31)
VDDANA: C1.1, C2.1, C3.1, C4.1, C82.1, C87.1, D4.1 (K), D24.1 (K), IC31.6 (VS), J13.1, R36.2, R39.2, R_BYPASS16.2, R_PUP2.1, R_PUP3.2, R_PUP4.2, R_PUP5.2, R_PUP6.1, R_TOP2.2, R_TOP3.2, R_TOP5.2, TP1.1, U1.8 (VDDANA), U1.21 (VDDIO), U1.56 (VDDIN), U2.2 (EN/*RST), U3.3 (VCC), U5.2 (EN/*RST)
