CHESS-mission/PULSE_ENG_PCB/(commit log)

2025-11-24 add pdu libery
    [AMDLA4020S-220MT.stp, AS0805KKX7R8BB105.stp, C0603C104K4NACAUTO.stp, C1812C106K3RACTM.stp, INA226AIDGSR.stp, L6982C33DR.stp, L6982C50DR.stp, LTC4451AV#TRMPBF.stp]
2025-11-24 Create .gitignore for KiCAD project files
    Added ignore patterns for KiCAD project files and temporary files.
2025-11-25 adapted footprint pahts
2025-11-26 added epc2152
    [EPC2152ENGRT--3DModel-STEP-269445.STEP]
2025-11-27 added schematics hirarchie
    [Control.kicad_sch, EPS_PDU.kicad_sch, EPS_power_supply.kicad_sch, ESQ-126-24-G-D.stp, PCU.kicad_sch, PULSE_ENG.kicad_sch]
2025-11-27 changed epc gan symbol
    [PCU.kicad_sch, PULSE_ENG.kicad_sch]
2025-12-01 Power supply
    [EPS_power_supply.kicad_sch, PULSE_ENG.kicad_sch]
2025-12-01 Add PCU buck converter section and notebook link
    [PCU.kicad_sch, PULSE_ENG.kicad_sch]
2025-12-01 Update .gitignore to include auto_saved_files
    Add entries to ignore auto-saved files in KiCAD projects.
2025-12-01 PDU_SCHEMATICS_v02 changes in the 3D
    [C0603X105K4RACAUTO.stp]
2025-12-01 UART ic added, SWD pins mapped
    [ADM3071EARZ.stp, EPS_PDU.kicad_sch, PULSE_ENG.kicad_sch, TC2030-IDC-NL.stp]
2025-12-03 Battery pack P1 connector
    Still needs to be mapped to mcu, MAY NEED MIRRORING (couldn't understand indexing order logic :( )
    [PULSE_ENG.kicad_sch]
2025-12-03 Created a page for BAT eFuse and current sensing. Updated the cControl page with part of the harware cutoff
    [Control.kicad_sch, PULSE_ENG.kicad_sch, untitled.kicad_sch]
2025-12-03 Created a page for PANNEL efuse, modifiel all to local labels, functionally finished
    [Control.kicad_sch, PANNEL_PS.kicad_sch, PULSE_ENG.kicad_sch]
2025-12-04 modifications on PDU
    [EE-360_PWM.kicad_pcb, EE-360_PWM.kicad_sch, EPS_PDU.kicad_sch, PULSE_ENG.kicad_sch]
2025-12-04 added 3d bat con
    [TW-08-07-G-D-375-188.stp]
2025-12-04 Some edits
    [Control.kicad_sch, PANNEL_PS.kicad_sch, PULSE_ENG.kicad_sch, untitled.kicad_sch]
2025-12-04 Modification of ROOT sheet blocks
    [Control.kicad_sch, PANNEL_PS.kicad_sch, PULSE_ENG.kicad_sch, untitled.kicad_sch]
2025-12-04 Final schematics pdu
    [EPS_PDU.kicad_sch]
2025-12-04 wrong folder
    [EE-360_PWM.kicad_pcb, EE-360_PWM.kicad_sch]
2026-02-26 fixed LDO
    [78404084470.stp, ATSAMD21G17A-AU.stp, C2012X8R1E105M125AE.stp, C3216X8R1E475M160AE.stp, LM139DR.stp, LT6108AIMS8-1#PBF.stp, PCU.kicad_sch, PULSE_ENG.kicad_pcb]
