CHESS-mission/PULSE_ENG_PCB/(notices)

Notices in the files:
PULSE_3D_Models/ESQ-126-24-G-D.stp:
author */ ('License CC BY-ND 4.0'),
